UBC-Hacker-Fab/tool-power-supply/tool-power-supply-v1/bus12v.kicad_sch

## KiCad design tool-power-supply-v1/bus12v.kicad_sch (2026-10-28)

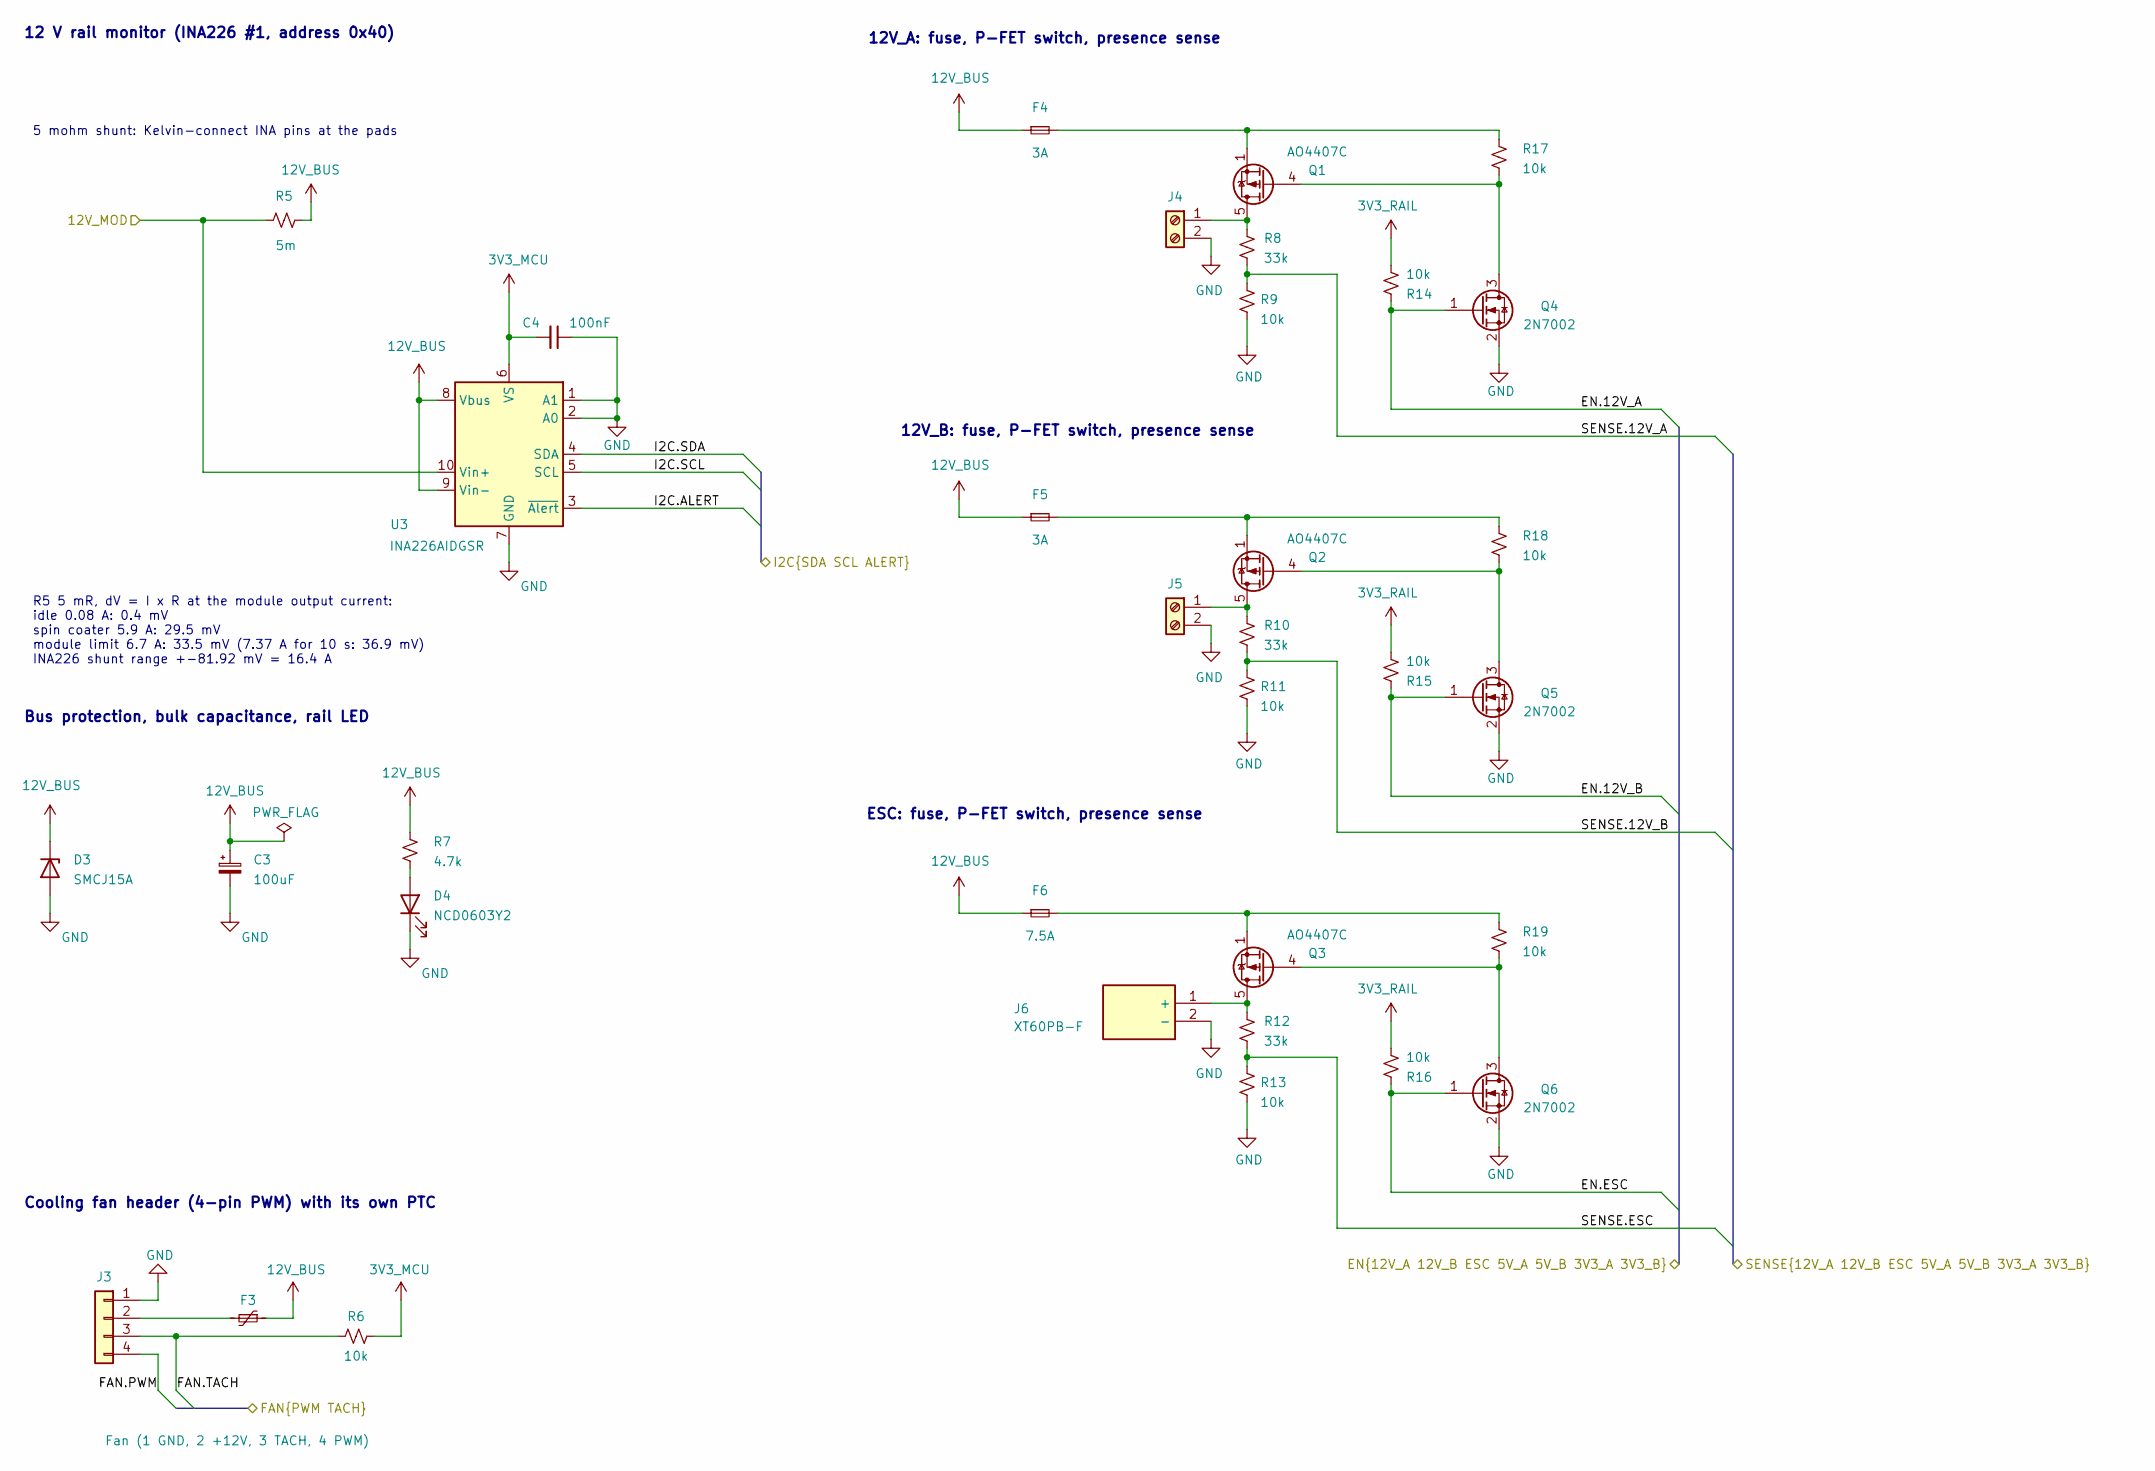
[picture p1: schematic bus12v.kicad_sch]

Parts:
C3: 100uF; CP_Elec_6.3x7.7; Voltage 35V; MPN RVE100UF35V67RV0072; LCSC C2836437
C4: 100nF; C_0603_1608Metric; Voltage 50V; MPN CC0603KRX7R9BB104; LCSC C14663
D3: SMCJ15A; D_SMC; MPN SMCJ15A; LCSC C42371550
D4: NCD0603Y2; LED_0603_1608Metric; MPN NCD0603Y2; LCSC C89811
F3: 500mA; Fuse_1206_3216Metric; MPN nSMD050-33V; LCSC C70077
F4, F5: 3A; Fuse_Blade_Keystone_3557-20_P13.47mm; MPN 0ATO003.V (Digikey F5040-ND)
F6: 7.5A; Fuse_Blade_Keystone_3557-20_P13.47mm; MPN 0ATO07.5V (Digikey F11167-ND)
J3: Fan (1 GND, 2 +12V, 3 TACH, 4 PWM); Molex_KK-254_AE-6410-04A_1x04_P2.54mm_Vertical; MPN 47053-1000; Mouser 538-47053-1000
J4, J5: DB128V-5.08-2P-GN-S; TerminalBlock_CUI_TB007-508-02_1x02_P5.08mm_Horizontal; MPN DB128V-5.08-2P-GN-S; LCSC C2915639
J6: XT60PB-F; XT60PBF; MPN XT60PB-F; LCSC C19268038
Q1, Q2, Q3: AO4407C; SOIC-8_3.9x4.9mm_P1.27mm; MPN AO4407C; LCSC C469397
Q4, Q5, Q6: 2N7002; SOT-23; MPN 2N7002; LCSC C8545
R5: 5m; R_2512_6332Metric; Tolerance 1%; MPN RLP25FEGMR005; LCSC C393074
R6, R9, R11, R13, R14, R15, R16, R17, R18, R19: 10k; R_0603_1608Metric; Tolerance 1%; MPN 0603WAF1002T5E; LCSC C25804
R7: 4.7k; R_0603_1608Metric; Tolerance 1%; MPN 0603WAF4701T5E; LCSC C23162
R8, R10, R12: 33k; R_0603_1608Metric; Tolerance 1%; MPN 0603WAF3302T5E; LCSC C4216
U3: INA226AIDGSR; MSOP-10_3x3mm_P0.5mm; MPN INA226AIDGSR; LCSC C49851

Connections:
3V3_MCU: C4.1, R6.2, U3.6 (VS)
3V3_RAIL: R14.2, R15.2, R16.2
12V_BUS: C3.1, D3.1 (K), F3.1, F4.1, F5.1, F6.1, R5.2, R7.1, U3.8 (Vbus), U3.9 (Vin-)
12V_MOD: R5.1, U3.10 (Vin+)
EN.12V_A: Q4.1 (G), R14.1
EN.12V_B: Q5.1 (G), R15.1
EN.ESC: Q6.1 (G), R16.1
FAN.PWM: J3.4
FAN.TACH: J3.3, R6.1
GND: C3.2, C4.2, D3.2 (A), D4.1 (K), J3.1, J4.2, J5.2, J6.2 (-), Q4.2 (S), Q5.2 (S), Q6.2 (S), R9.2, R11.2, R13.2, U3.1 (A1), U3.2 (A0), U3.7 (GND)
I2C.ALERT: U3.3 (~Alert)
I2C.SCL: U3.5 (SCL)
I2C.SDA: U3.4 (SDA)
unnamed: D4.2 (A), R7.2
unnamed: F3.2, J3.2
unnamed: F4.2, Q1.1 (S), Q1.2 (S), Q1.3 (S), R17.1
unnamed: F5.2, Q2.1 (S), Q2.2 (S), Q2.3 (S), R18.1
unnamed: F6.2, Q3.1 (S), Q3.2 (S), Q3.3 (S), R19.1
unnamed: J4.1, Q1.5 (D), Q1.6 (D), Q1.7 (D), Q1.8 (D), R8.1
unnamed: J5.1, Q2.5 (D), Q2.6 (D), Q2.7 (D), Q2.8 (D), R10.1
unnamed: J6.1 (+), Q3.5 (D), Q3.6 (D), Q3.7 (D), Q3.8 (D), R12.1
unnamed: Q1.4 (G), Q4.3 (D), R17.2
unnamed: Q2.4 (G), Q5.3 (D), R18.2
unnamed: Q3.4 (G), Q6.3 (D), R19.2
SENSE.12V_A: R8.2, R9.1
SENSE.12V_B: R10.2, R11.1
SENSE.ESC: R12.2, R13.1

Notes on the sheet:
ESC: fuse, P-FET switch, presence sense
Cooling fan header (4-pin PWM) with its own PTC
Bus protection, bulk capacitance, rail LED
12 V rail monitor (INA226 #1, address 0x40)
12V_A: fuse, P-FET switch, presence sense
R5 5 mR, dV = I x R at the module output current: idle 0.08 A: 0.4 mV spin coater 5.9 A: 29.5 mV module limit 6.7 A: 33.5 mV (7.37 A for 10 s: 36.9 mV) INA226 shunt range +-81.92 mV = 16.4 A
5 mohm shunt: Kelvin-connect INA pins at the pads
12V_B: fuse, P-FET switch, presence sense
