UBC-Hacker-Fab/tool-power-supply/tool-power-supply-v1/mains.kicad_sch

## KiCad design tool-power-supply-v1/mains.kicad_sch (2026-10-16)

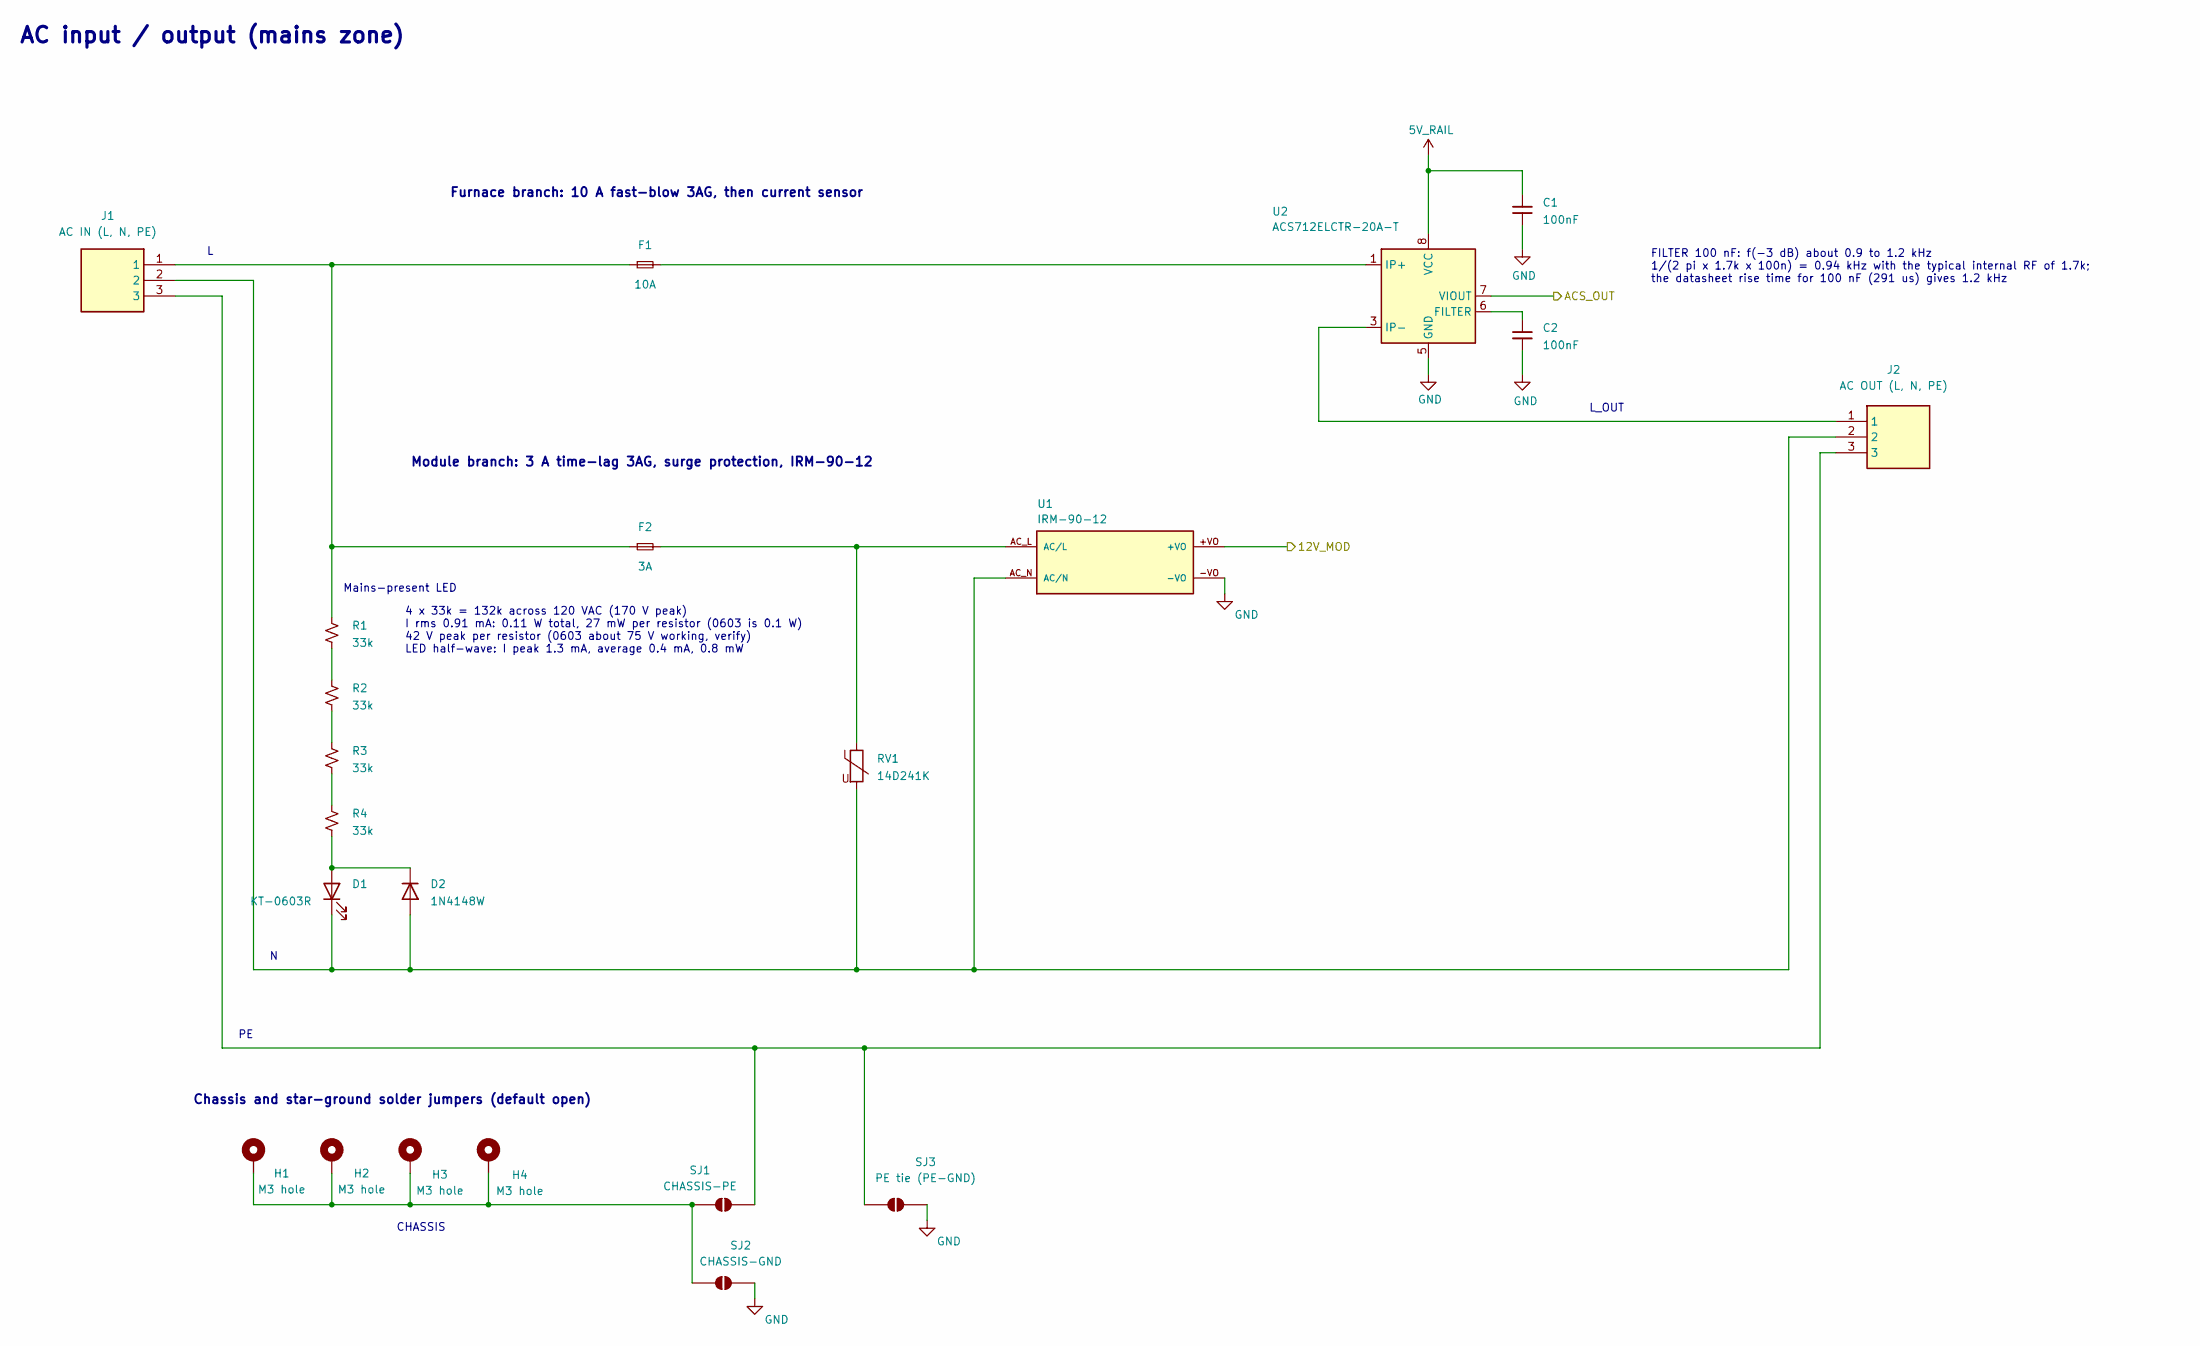
[picture p2: schematic mains.kicad_sch]

Parts:
C1, C2: 100nF; C_0603_1608Metric; Voltage 50V; MPN CC0603KRX7R9BB104; LCSC C14663
D1: KT-0603R; LED_0603_1608Metric; MPN KT-0603R; LCSC C2286
D2: 1N4148W; D_SOD-123; MPN 1N4148W; LCSC C81598
F1: 10A; Fuse_3AG_6.3x32mm_Clips_Littelfuse_102_122_P34.21mm; MPN 0314010.HXP (Digikey F3222-ND)
F2: 3A; Fuse_3AG_6.3x32mm_Clips_Littelfuse_102_122_P34.21mm; MPN 0313003.HXP (Digikey F2545-ND; 4A 03130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
H1, H2, H3, H4: M3 hole; MountingHole_3.2mm_M3_Pad
J1: AC IN (L, N, PE); TerminalBlock_Ningbo-Kagnex_HB9500M_1x03_P9.5mm; MPN HB9500M-9.5-03P-13-00A; LCSC C162697
J2: AC OUT (L, N, PE); TerminalBlock_Ningbo-Kagnex_HB9500M_1x03_P9.5mm; MPN HB9500M-9.5-03P-13-00A; LCSC C162697
R1, R2, R3, R4: 33k; R_0603_1608Metric; Tolerance 1%; MPN 0603WAF3302T5E; LCSC C4216
RV1: 14D241K; RV_Disc_D16.5mm_W6.7mm_P7.5mm; MPN 14D241K; LCSC C49072887
SJ1: CHASSIS-PE; SolderJumper-2_P1.3mm_Open_RoundedPad1.0x1.5mm
SJ2: CHASSIS-GND; SolderJumper-2_P1.3mm_Open_RoundedPad1.0x1.5mm
SJ3: PE tie (PE-GND); SolderJumper-2_P1.3mm_Open_RoundedPad1.0x1.5mm
U1: IRM-90-12; CONV_IRM-90-12; MPN IRM-90-12; LCSC C6577385
U2: ACS712ELCTR-20A-T; SOIC-8_3.9x4.9mm_P1.27mm; MPN ACS712ELCTR-20A-T; LCSC C10681

Connections:
5V_RAIL: C1.1, U2.8 (VCC)
12V_MOD: U1.+VO
ACS_OUT: U2.7 (VIOUT)
GND: C1.2, C2.2, SJ2.2 (B), SJ3.2 (B), U1.-VO, U2.5 (GND)
unnamed: C2.1, U2.6 (FILTER)
unnamed: D1.1 (K), D2.2 (A), J1.2, J2.2, RV1.2, U1.AC_N (AC/N)
unnamed: D1.2 (A), D2.1 (K), R4.2
unnamed: F1.1, F2.1, J1.1, R1.1
unnamed: F1.2, U2.1 (IP+), U2.2 (IP+)
unnamed: F2.2, RV1.1, U1.AC_L (AC/L)
unnamed: H1.1, H2.1, H3.1, H4.1, SJ1.1 (A), SJ2.1 (A)
unnamed: J1.3, J2.3, SJ1.2 (B), SJ3.1 (A)
unnamed: J2.1, U2.3 (IP-), U2.4 (IP-)
unnamed: R1.2, R2.1
unnamed: R2.2, R3.1
unnamed: R3.2, R4.1

Notes on the sheet:
Furnace branch: 10 A fast-blow 3AG, then current sensor
AC input / output (mains zone)
Mains-present LED
FILTER 100 nF: f(-3 dB) about 0.9 to 1.2 kHz 1/(2 pi x 1.7k x 100n) = 0.94 kHz with the typical internal RF of 1.7k; the datasheet rise time for 100 nF (291 us) gives 1.2 kHz
Chassis and star-ground solder jumpers (default open)
4 x 33k = 132k across 120 VAC (170 V peak) I rms 0.91 mA: 0.11 W total, 27 mW per resistor (0603 is 0.1 W) 42 V peak per resistor (0603 about 75 V working, verify) LED half-wave: I peak 1.3 mA, average 0.4 mA, 0.8 mW
L_OUT
Module branch: 3 A time-lag 3AG, surge protection, IRM-90-12
CHASSIS
