UBC-Hacker-Fab/tool-power-supply/tool-power-supply-v1/mcu.kicad_sch

## KiCad design tool-power-supply-v1/mcu.kicad_sch (2026-10-28)

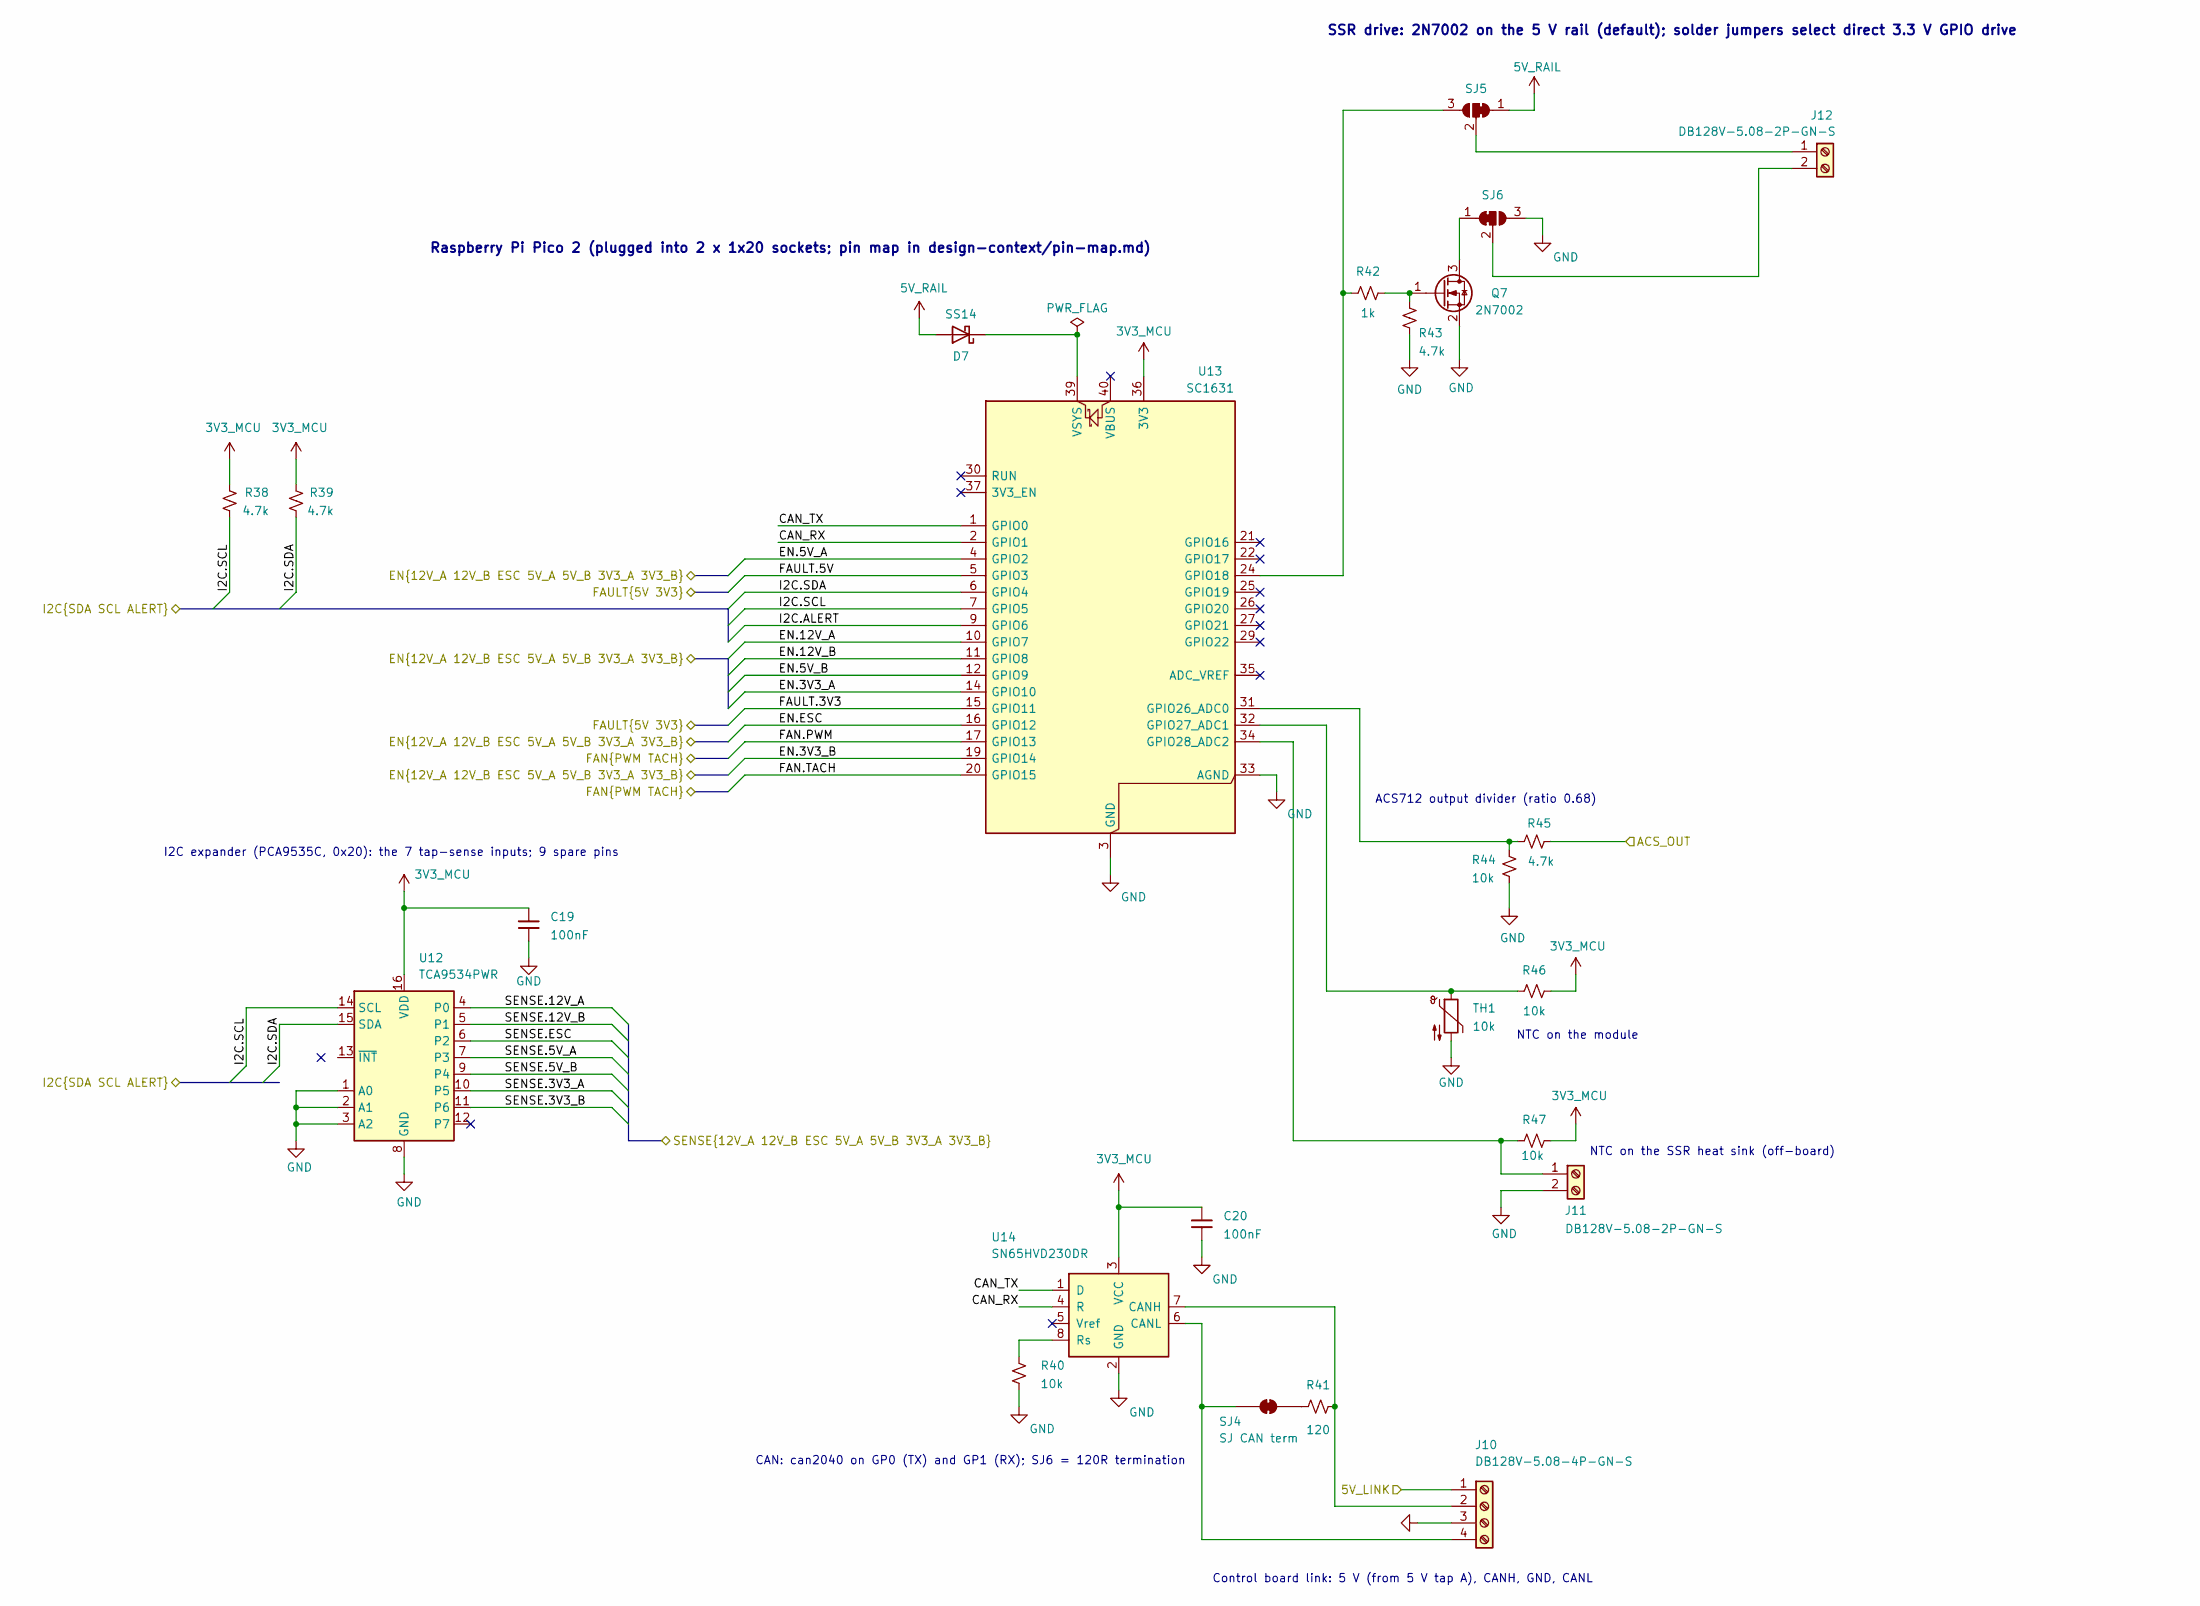
[picture p3: schematic mcu.kicad_sch]

Parts:
C19, C20: 100nF; C_0603_1608Metric; Voltage 50V; MPN CC0603KRX7R9BB104; LCSC C14663
D7: SS14; D_SMA; MPN SS14; LCSC C2480
J10: DB128V-5.08-4P-GN-S; TerminalBlock_CUI_TB007-508-04_1x04_P5.08mm_Horizontal; MPN DB128V-5.08-4P-GN-S; LCSC C2915641
J11, J12: DB128V-5.08-2P-GN-S; TerminalBlock_CUI_TB007-508-02_1x02_P5.08mm_Horizontal; MPN DB128V-5.08-2P-GN-S; LCSC C2915639
Q7: 2N7002; SOT-23; MPN 2N7002; LCSC C8545
R38, R39, R43, R45: 4.7k; R_0603_1608Metric; Tolerance 1%; MPN 0603WAF4701T5E; LCSC C23162
R40, R44, R46, R47: 10k; R_0603_1608Metric; Tolerance 1%; MPN 0603WAF1002T5E; LCSC C25804
R41: 120; R_0603_1608Metric; Tolerance 1%; MPN 0603WAF1200T5E; LCSC C22787
R42: 1k; R_0603_1608Metric; Tolerance 1%; MPN 0603WAF1001T5E; LCSC C21190
SJ4: SJ CAN term; SolderJumper-2_P1.3mm_Bridged_RoundedPad1.0x1.5mm
SJ5: SJ SSR+ (1-2 = 5V, 2-3 = GPIO); SolderJumper-3_P1.3mm_Bridged12_RoundedPad1.0x1.5mm
SJ6: SJ SSR- (1-2 = MOSFET, 2-3 = GND); SolderJumper-3_P1.3mm_Bridged12_RoundedPad1.0x1.5mm
TH1: 10k; R_0603_1608Metric; MPN NCP18XH103F03RB; LCSC C13564
U12: TCA9534PWR; TSSOP-16_4.4x5mm_P0.65mm; MPN TCA9534PWR; LCSC C783615
U13: SC1631; RaspberryPi_Pico_Common_THT; MPN SC1631; LCSC C41407547
U14: SN65HVD230DR; SOIC-8_3.9x4.9mm_P1.27mm; MPN SN65HVD230DR; LCSC C12084

Connections:
3V3_MCU: C19.1, C20.1, R38.2, R39.2, R46.1, R47.1, U12.16 (VDD), U13.36 (3V3), U14.3 (VCC)
5V_LINK: J10.1
5V_RAIL: D7.2 (A), SJ5.1 (A)
ACS_OUT: R45.1
CAN_RX: U13.2 (GPIO1), U14.4 (R)
CAN_TX: U13.1 (GPIO0), U14.1 (D)
EN.3V3_A: U13.14 (GPIO10)
EN.3V3_B: U13.19 (GPIO14)
EN.5V_A: U13.4 (GPIO2)
EN.5V_B: U13.12 (GPIO9)
EN.12V_A: U13.10 (GPIO7)
EN.12V_B: U13.11 (GPIO8)
EN.ESC: U13.16 (GPIO12)
FAN.PWM: U13.17 (GPIO13)
FAN.TACH: U13.20 (GPIO15)
FAULT.3V3: U13.15 (GPIO11)
FAULT.5V: U13.5 (GPIO3)
GND: C19.2, C20.2, J10.3, J11.2, Q7.2 (S), R40.2, R43.2, R44.2, SJ6.3 (B), TH1.2, U12.1 (A0), U12.2 (A1), U12.3 (A2), U12.8 (GND), U13.3 (GND), U13.8 (GND), U13.13 (GND), U13.18 (GND), U13.23 (GND), U13.28 (GND), U13.33 (AGND), U13.38 (GND), U14.2 (GND)
I2C.ALERT: U13.9 (GPIO6)
I2C.SCL: R38.1, U12.14 (SCL), U13.7 (GPIO5)
I2C.SDA: R39.1, U12.15 (SDA), U13.6 (GPIO4)
unnamed: D7.1 (K), U13.39 (VSYS)
unnamed: J10.2, R41.2, U14.7 (CANH)
unnamed: J10.4, SJ4.1 (A), U14.6 (CANL)
unnamed: J11.1, R47.2, U13.34 (GPIO28_ADC2)
unnamed: J12.1, SJ5.2 (C)
unnamed: J12.2, SJ6.2 (C)
unnamed: Q7.1 (G), R42.2, R43.1
unnamed: Q7.3 (D), SJ6.1 (A)
unnamed: R40.1, U14.8 (Rs)
unnamed: R41.1, SJ4.2 (B)
unnamed: R42.1, SJ5.3 (B), U13.24 (GPIO18)
unnamed: R44.1, R45.2, U13.31 (GPIO26_ADC0)
unnamed: R46.2, TH1.1, U13.32 (GPIO27_ADC1)
SENSE.3V3_A: U12.10 (P5)
SENSE.3V3_B: U12.11 (P6)
SENSE.5V_A: U12.7 (P3)
SENSE.5V_B: U12.9 (P4)
SENSE.12V_A: U12.4 (P0)
SENSE.12V_B: U12.5 (P1)
SENSE.ESC: U12.6 (P2)

Notes on the sheet:
NTC on the SSR heat sink (off-board)
ACS712 output divider (ratio 0.68)
Raspberry Pi Pico 2 (plugged into 2 x 1x20 sockets; pin map in design-context/pin-map.md)
NTC on the module
CAN: can2040 on GP0 (TX) and GP1 (RX); SJ6 = 120R termination
SSR drive: 2N7002 on the 5 V rail (default); solder jumpers select direct 3.3 V GPIO drive
Control board link: 5 V (from 5 V tap A), CANH, GND, CANL
I2C expander (PCA9535C, 0x20): the 7 tap-sense inputs; 9 spare pins
