UBC-Hacker-Fab/tool-power-supply/tools/schematic/build.py

import sys,os,shutil
sys.path.insert(0,os.path.dirname(os.path.abspath(__file__)))
import design
from design import *
OUT=sys.argv[1] if len(sys.argv)>1 else os.path.join(os.path.dirname(os.path.abspath(__file__)),'..','..','tool-power-supply-v1')
os.makedirs(OUT,exist_ok=True)
# refs
cnt={}
for n in ORDER:
    for title,comps in sheets[n].sections:
        for c in comps:
            pre=c.prefix
            cnt[pre]=cnt.get(pre,0)+1
            c.ref=(f'{pre}{cnt[pre]:02d}' if pre.startswith('#') else f'{pre}{cnt[pre]}')
# layout + emit
papers={}
for n in ORDER:
    sh=sheets[n]
    pname,W,H=layout(sh); papers[n]=pname
    path=f'/{root_uuid}/{sh.uuid}'
    tree=emit_sheet(sh,pname,W,H,None,path)
    fn=f'{OUT}/{n}.kicad_sch'
    open(fn,'w').write(dump(tree)+'\n')
    print(n,pname,sum(len(c) for _,c in sh.sections),'components')
# root
rk=[['version','20260306'],['generator',Q('eeschema')],['generator_version',Q('10.0')],['uuid',Q(root_uuid)],['paper',Q('A3')],
    ['title_block',['title',Q('HackerFab tool power supply')],['date',Q('2026-10-14')],['rev',Q('draft 1')],['comment','1',Q('Generated by tools/gen_schematic.py')]],['lib_symbols']]
x=25.4;y=45
names={'mains':'Mains zone: AC in/out, fuses, module, furnace current sense','bus12v':'12 V bus: monitor, TVS, branch switches, fan','rails':'5 V / 3.3 V bucks, monitors and taps','mcu':'Pico 2, analog inputs, SSR drive'}
for i,n in enumerate(ORDER):
    sh=sheets[n]
    rk.append(['sheet',['at',fmt(x),fmt(y)],['size','70','30'],['exclude_from_sim','no'],['in_bom','yes'],['on_board','yes'],['dnp','no'],['fields_autoplaced','yes'],['stroke',['width','0.1524'],['type','solid']],['fill',['color','0','0','0','0']],['uuid',Q(sh.uuid)],
      ['property',Q('Sheetname'),Q(n),['at',fmt(x),fmt(y-1),'0'],['effects',['font',['size','1.27','1.27']],['justify','left','bottom']]],
      ['property',Q('Sheetfile'),Q(f'{n}.kicad_sch'),['at',fmt(x),fmt(y+31),'0'],['effects',['font',['size','1.27','1.27']],['justify','left','top']]],
      ['instances',['project',Q(PROJECT),['path',Q('/'+root_uuid),['page',Q(str(i+2))]]]]])
    rk.append(['text',Q(names[n]),['exclude_from_sim','no'],['at',fmt(x),fmt(y+36),'0'],['effects',['font',['size','1.27','1.27']],['justify','left','top']],['uuid',Q(U())]])
    x+=85
    if x>330: x=25.4;y+=60
notes=("Rev 1 power board (draft). Sheets are connected by global labels (no sheet pins). Source of truth for decisions: design-context/design-decisions.md; BOM: design-context/bom.md; pin map: design-context/pin-map.md. "
 "Generated by tools/gen_schematic.py; manual edits are overwritten if the script is re-run.")
rk.append(['text',Q(notes),['exclude_from_sim','no'],['at','25.4','25.4','0'],['effects',['font',['size','1.27','1.27']],['justify','left','top']],['uuid',Q(U())]])
rk.append(['sheet_instances',['path',Q('/'),['page',Q('1')]]]); rk.append(['embedded_fonts','no'])
open(f'{OUT}/{PROJECT}.kicad_sch','w').write(dump(['kicad_sch']+rk)+'\n')
print('root written')
