UBC-Hacker-Fab/tool-power-supply/(commit log)

2026-10-14 schematic update: first agent attempt
2026-10-14 schematic update: cleaned up by using sheet labels and busses, updated documentation
2026-10-16 schematic update: finished cleaning up
